schlae/plaid-bib-cpld/images/PlaidBibCPLD.jpg

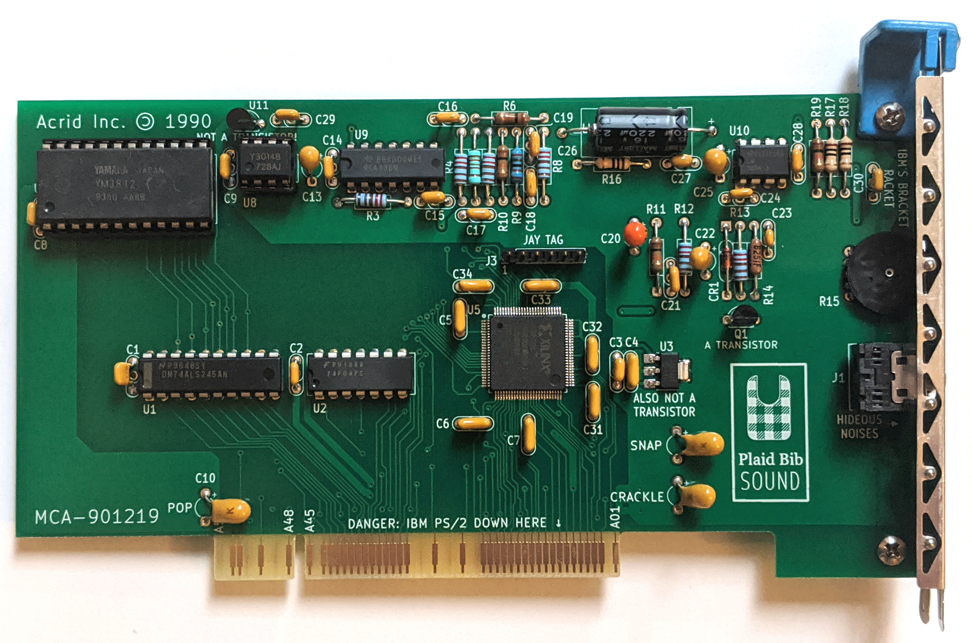
images/PlaidBibCPLD.jpg
