schlae/plaid-bib-cpld/PlaidBibCPLD.pdf

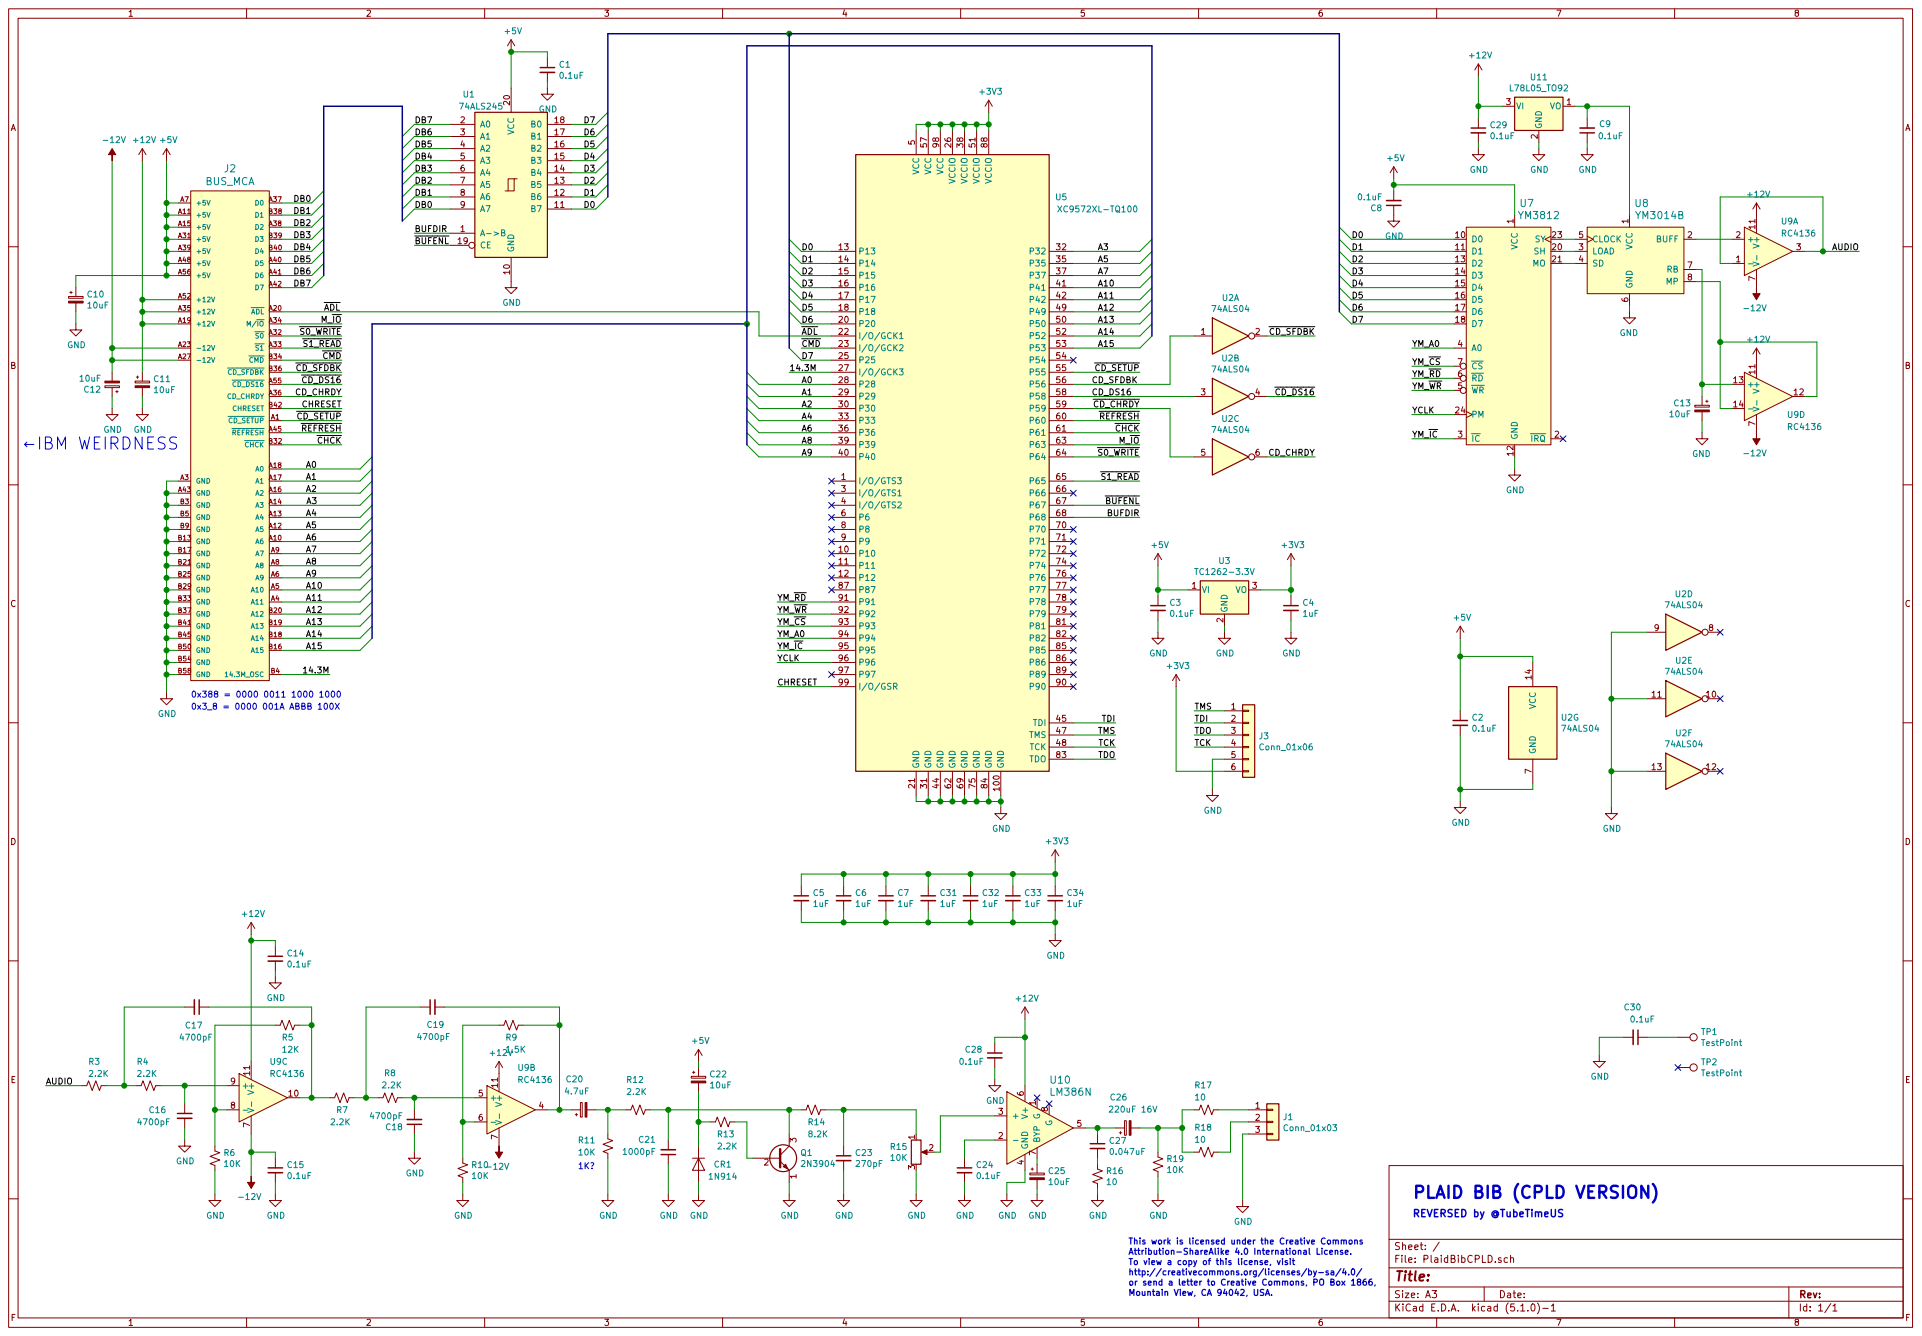
[picture p2: page 1]

+12V PLAID BIB (CPLD VERSION)
+5V GND

This work is licensed under the Creative Commons Attribution-ShareAlike 4.0 International License. To view a copy of this license, visit

http://creativecommons.org/licenses/by-sa/4.0/
or send a letter to Creative Commons, PO Box 1866,
Mountain View, CA 94042, USA.
