schlae/plaid-bib-cpld/PlaidBibCPLD.kicad_pcb

## KiCad design PlaidBibCPLD.kicad_pcb (2020-01-09)

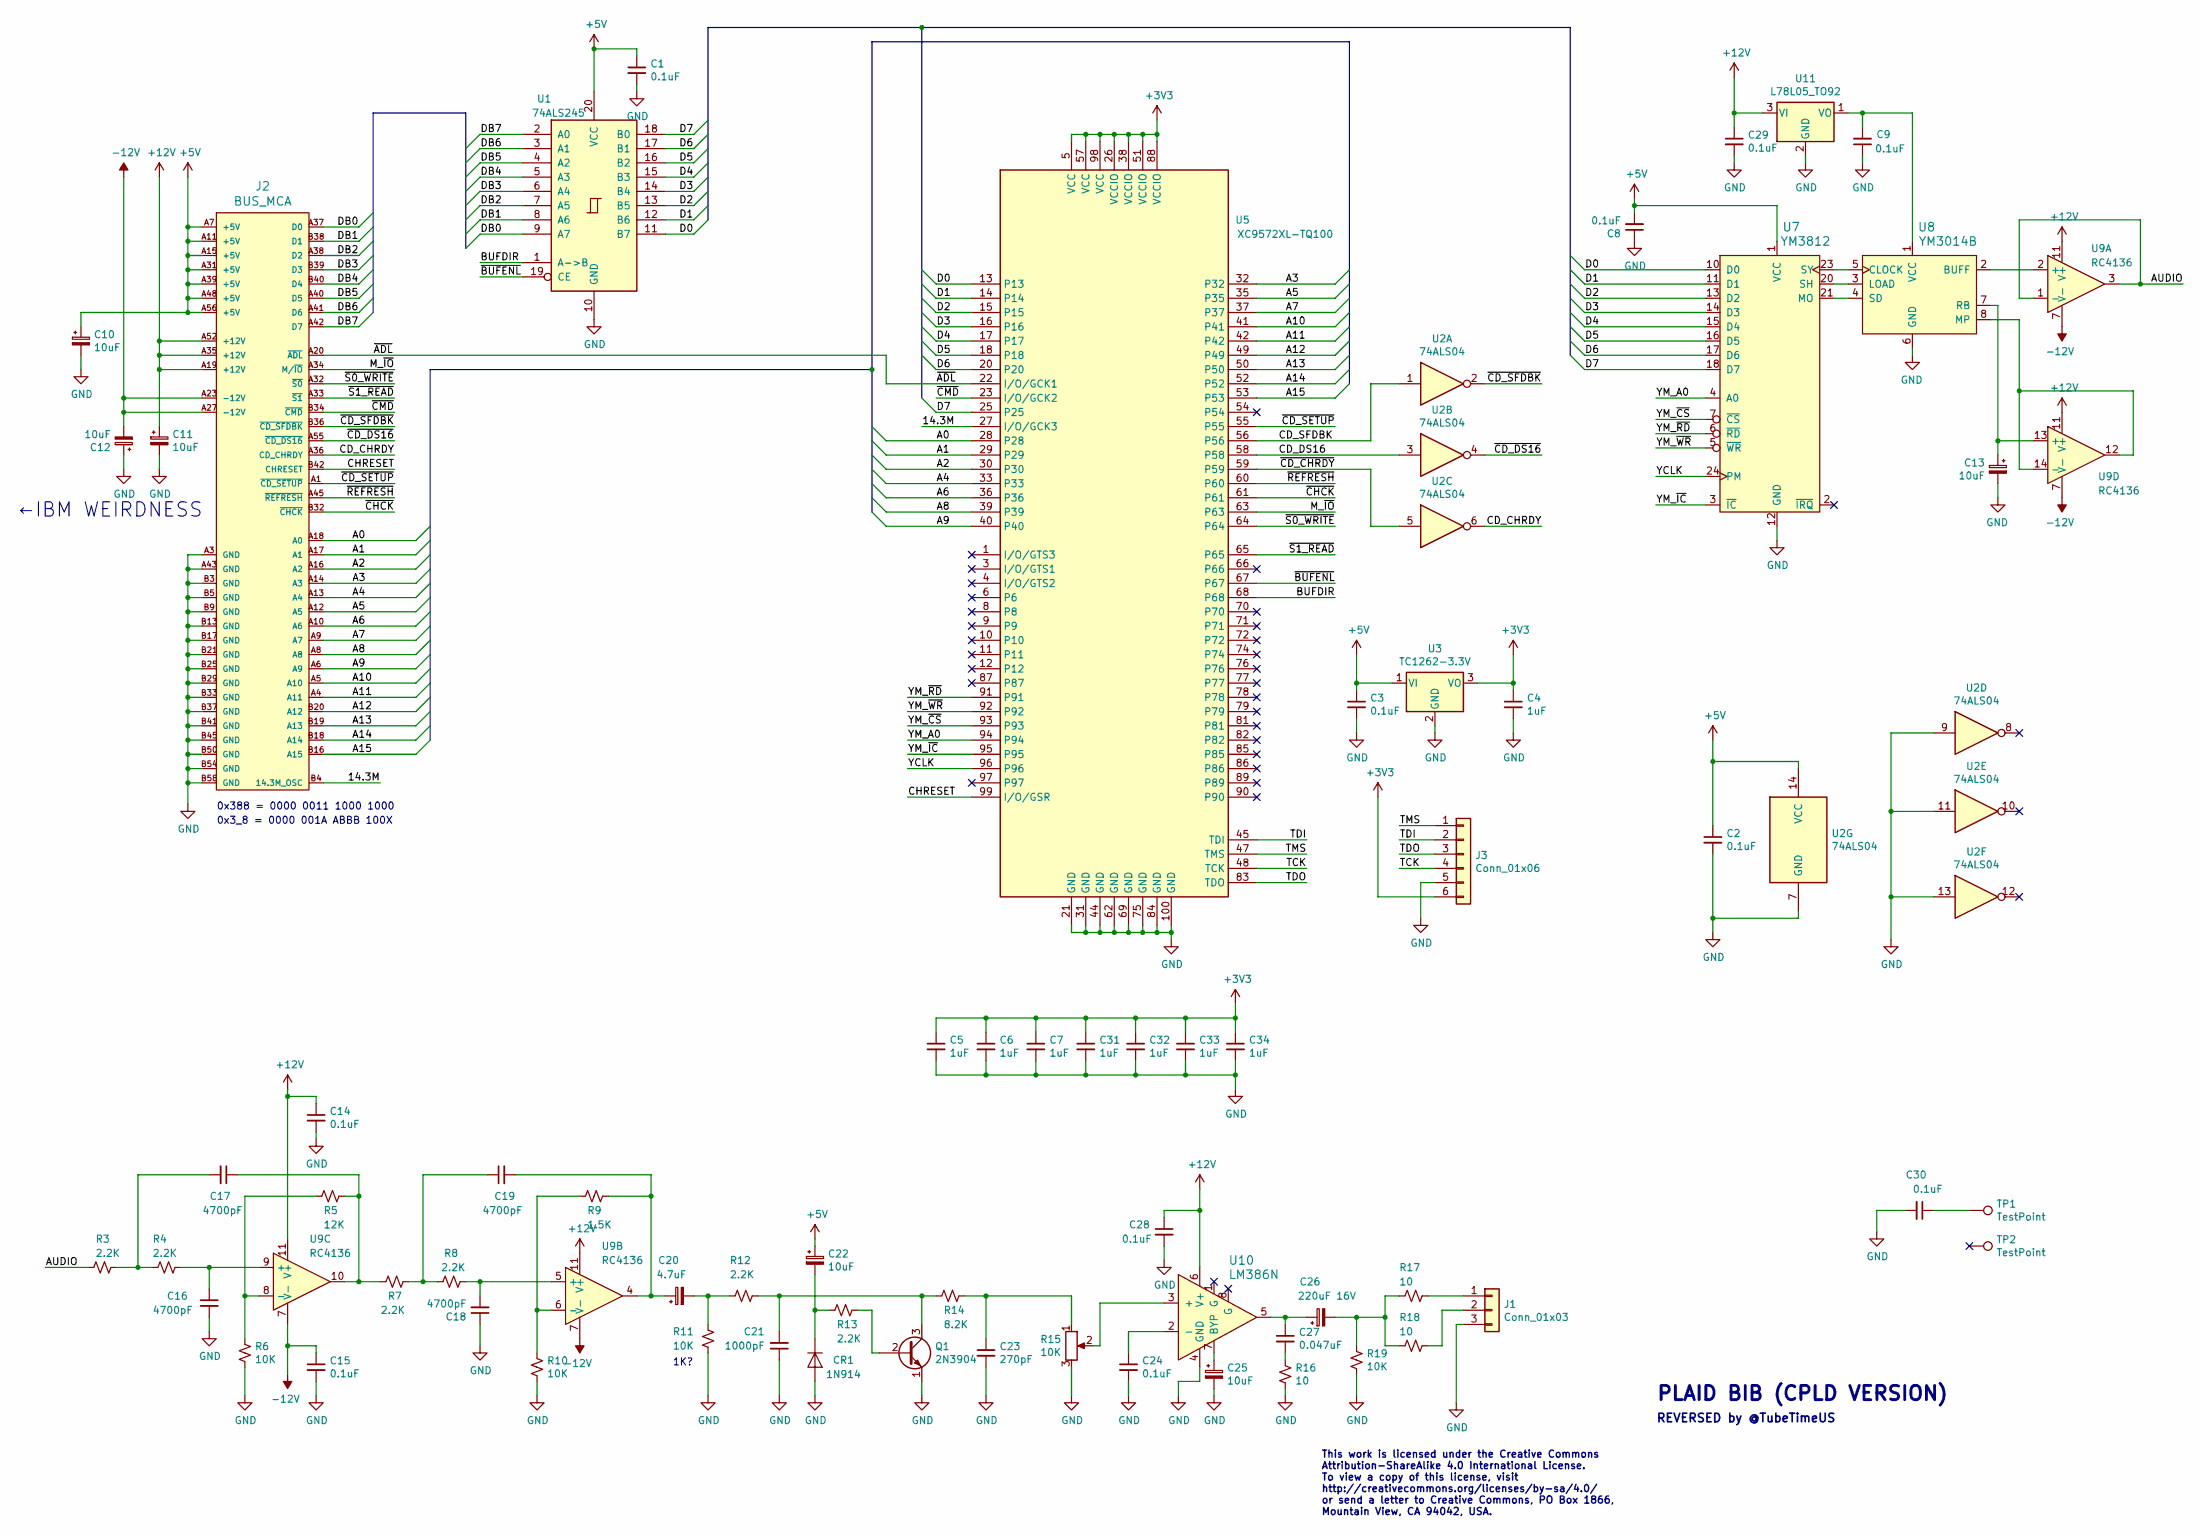
[picture p3: schematic PlaidBibCPLD.sch]

Parts:
C1, C2, C3, C8, C9, C14, C15, C24, C28, C29, C30: 0.1uF; CAP23; Mouser 581-AR215C104K4R
C4, C5, C6, C7, C31, C32, C33, C34: 1uF; CAP23; Mouser 581-AR215C104K4R
C10, C11, C12, C13, C22, C25: 10uF; CAPAP200; Mouser 581-TAP106M025CRW
C16, C17, C18, C19: 4700pF; CAP23; Mouser 581-AR211C472K4R
C20: 4.7uF; CAPAP200; Mouser 581-TAP475K016SCS
C21: 1000pF; CAP23; Mouser 581-AR211C102K4R
C23: 270pF; CAP23; Mouser 594-S271K43SL0N6TK5R
C26: 220uF 16V; CAPA1000; Mouser 647-TVX1C221MAD
C27: 0.047uF; CAP23; Mouser 581-AR215C473K4R
CR1: 1N914; DIOA500; Mouser 512-1N914
J1: Conn_01x03; SJ1-3553; Mouser 490-SJ1-3553NG
J2: BUS_MCA; BUS_MCA_ADLIB
J3: Conn_01x06; Pin_Header_Straight_1x06_Pitch2.54mm
Q1: 2N3904; TO92-IL; Mouser 512-2N3904BU
R3, R4, R7, R8, R12, R13: 2.2K; RESA500; Mouser 291-2.2K-RC
R5: 12K; RESA500; Mouser 291-12K-RC
R6, R10, R11, R19: 10K; RESA500; Mouser 291-10K-RC
R9: 1.5K; RESA500; Mouser 291-1.5K-RC
R14: 8.2K; RESA500; Mouser 291-8.2K-RC
R15: 10K; RK14J11A000G; Mouser 688-RK14J11A000G
R16, R17, R18: 10; RESA500; Mouser 291-10-RC
TP1, TP2: TestPoint; MH_125
U1: 74ALS245; DIP300_20N; Mouser 595-SN74ALS245AN
U2: 74ALS04; DIP254P762X635-14; Mouser 595-SN74ALS04BN
U3: TC1262-3.3V; SOT230P700X170-3; Mouser 579-TC1262-3.3VDB
U5: XC9572XL-TQ100; TQFP50P1600X1600X140-100; Mouser 217-9572XL-10TQG100C
U7: YM3812; DIP600_24N
U8: YM3014B; DIP300_8N
U9: RC4136; DIP300_14N; Mouser 595-RC4136N
U10: LM386N; DIP300_8N; Mouser 926-LM386N-4/NOPB
U11: L78L05_TO92; TO92-IL; Mouser 511-L78L05ACZ

Connections:
+3V3: C4.1, C5.1, C6.1, C7.1, C31.1, C32.1, C33.1, C34.1, J3.6, U3.3 (VO), U5.5 (VCC), U5.26 (VCCIO), U5.38 (VCCIO), U5.51 (VCCIO), U5.57 (VCC), U5.88 (VCCIO), U5.98 (VCC)
+5V: C1.1, C2.1, C3.1, C8.2, C10.1, C22.1, J2.A7 (+5V), J2.A11 (+5V), J2.A15 (+5V), J2.A31 (+5V), J2.A39 (+5V), J2.A48 (+5V), J2.A56 (+5V), U1.20 (VCC), U2.14 (VCC), U3.1 (VI), U7.1 (VCC)
+12V: C11.1, C14.1, C28.1, C29.1, J2.A19 (+12V), J2.A35 (+12V), J2.A52 (+12V), U9.11 (V+), U10.6 (V+), U11.3 (VI)
-12V: C12.2, C15.1, J2.A23 (-12V), J2.A27 (-12V), U9.7 (V-)
/14.3M: J2.B4 (14.3M_OSC), U5.27 (I/O/GCK3)
/A0: J2.A18 (A0), U5.28
/A1: J2.A17 (A1), U5.29
/A2: J2.A16 (A2), U5.30
/A3: J2.A14 (A3), U5.32
/A4: J2.A13 (A4), U5.33
/A5: J2.A12 (A5), U5.35
/A6: J2.A10 (A6), U5.36
/A7: J2.A9 (A7), U5.37
/A8: J2.A8, U5.39
/A9: J2.A6 (A9), U5.40
/A10: J2.A5 (A10), U5.41
/A11: J2.A4 (A11), U5.42
/A12: J2.B20 (A12), U5.49
/A13: J2.B19 (A13), U5.50
/A14: J2.B18 (A14), U5.52
/A15: J2.B16 (A15), U5.53
/AUDIO: R3.2, U9.1 (-), U9.3
/BUFDIR: U1.1 (A->B), U5.68
/CD_CHRDY: J2.A36 (CD_CHRDY), U2.6
/CD_DS16: U2.3, U5.58
/CD_SFDBK: U2.1, U5.56
/CHRESET: J2.B42 (CHRESET), U5.99 (I/O/GSR)
/D0: U1.11 (B7), U5.13, U7.10 (D0)
/D1: U1.12 (B6), U5.14, U7.11 (D1)
/D2: U1.13 (B5), U5.15, U7.13 (D2)
/D3: U1.14 (B4), U5.16, U7.14 (D3)
/D4: U1.15 (B3), U5.17, U7.15 (D4)
/D5: U1.16 (B2), U5.18, U7.16 (D5)
/D6: U1.17 (B1), U5.20, U7.17 (D6)
/D7: U1.18 (B0), U5.25, U7.18 (D7)
/DB0: J2.A37 (D0), U1.9 (A7)
/DB1: J2.B38 (D1), U1.8 (A6)
/DB2: J2.A38 (D2), U1.7 (A5)
/DB3: J2.B39 (D3), U1.6 (A4)
/DB4: J2.B40 (D4), U1.5 (A3)
/DB5: J2.A40 (D5), U1.4 (A2)
/DB6: J2.A41 (D6), U1.3 (A1)
/DB7: J2.A42 (D7), U1.2 (A0)
/M_~IO: J2.A34 (M/~IO), U5.63
/TCK: J3.4, U5.48 (TCK)
/TDI: J3.2, U5.45 (TDI)
/TDO: J3.3, U5.83 (TDO)
/TMS: J3.1, U5.47 (TMS)
/YCLK: U5.96, U7.24 (PM)
/YM_A0: U5.94, U7.4 (A0)
/YM_~CS: U5.93, U7.7 (~CS)
/YM_~IC: U5.95, U7.3 (~IC)
/YM_~RD: U5.91, U7.6 (~RD)
/YM_~WR: U5.92, U7.5 (~WR)
/~ADL: J2.A20 (~ADL), U5.22 (I/O/GCK1)
/~BUFENL: U1.19 (CE), U5.67
/~CD_CHRDY: U2.5, U5.59
/~CD_DS16: J2.A55 (~CD_DS16), U2.4
/~CD_SETUP: J2.A1 (~CD_SETUP), U5.55
/~CD_SFDBK: J2.B36 (~CD_SFDBK), U2.2
/~CHCK: J2.B32 (~CHCK), U5.61
/~CMD: J2.B34 (~CMD), U5.23 (I/O/GCK2)
/~REFRESH: J2.A45 (~REFRESH), U5.60
/~S0_WRITE: J2.A32 (~S0), U5.64
/~S1_READ: J2.A33 (~S1), U5.65
GND: C1.2, C2.2, C3.2, C4.2, C5.2, C6.2, C7.2, C8.1, C9.1, C10.2, C11.2, C12.1, C13.2, C14.2, C15.2, C16.2, C18.1, C21.1, C23.2, C24.2, C25.2, C28.2, C29.2, C30.2, C31.2, C32.2, C33.2, C34.2, CR1.2 (A), J1.3, J2.A3 (GND), J2.A43 (GND), J2.B3 (GND), J2.B5 (GND), J2.B9 (GND), J2.B13 (GND), J2.B17 (GND), J2.B21 (GND), J2.B25 (GND), J2.B29 (GND), J2.B33 (GND), J2.B37 (GND), J2.B41 (GND), J2.B45 (GND), J2.B50 (GND), J2.B54 (GND), J2.B58 (GND), J3.5, Q1.1 (E), R6.2, R10.2, R11.2, R15.3, R16.2, R19.2, U1.10 (GND), U2.7 (GND), U2.9, U2.11, U2.13, U3.2 (GND), U5.21 (GND), U5.31 (GND), U5.44 (GND), U5.62 (GND), U5.69 (GND), U5.75 (GND), U5.84 (GND), U5.100 (GND), U7.12 (GND), U8.6 (GND), U10.4 (GND), U11.2 (GND)
unnamed: C9.2, U8.1 (VCC), U11.1 (VO)
unnamed: C13.1, U8.7 (RB), U9.13 (+)
unnamed: C16.1, R4.1, U9.9 (+)
unnamed: C17.1, R5.1, R7.2, U9.10
unnamed: C17.2, R3.1, R4.2
unnamed: C18.2, R8.2, U9.5 (+)
unnamed: C19.1, R7.1, R8.1
unnamed: C19.2, C20.1, R9.1, U9.4
unnamed: C20.2, R11.1, R12.2
unnamed: C21.2, Q1.3 (C), R12.1, R14.2
unnamed: C22.2, CR1.1 (K), R13.2
unnamed: C23.1, R14.1, R15.1
unnamed: C24.1, U10.2 (-)
unnamed: C25.1, U10.7 (BYP)
unnamed: C26.1, C27.1, U10.5
unnamed: C26.2, R17.1, R18.1, R19.1
unnamed: C27.2, R16.1
unnamed: C30.1, TP1.1
unnamed: J1.1, R17.2
unnamed: J1.2, R18.2
unnamed: Q1.2 (B), R13.1
unnamed: R5.2, R6.1, U9.8 (-)
unnamed: R9.2, R10.1, U9.6 (-)
unnamed: R15.2, U10.3 (+)
unnamed: U7.20 (SH), U8.3 (LOAD)
unnamed: U7.21 (MO), U8.4 (SD)
unnamed: U7.23 (SY), U8.5 (CLOCK)
unnamed: U8.2 (BUFF), U9.2 (+)
unnamed: U8.8 (MP), U9.12, U9.14 (-)

Notes on the sheet:
0x388 = 0000 0011 1000 1000
1K?
←IBM WEIRDNESS
0x3_8 = 0000 001A ABBB 100X
PLAID BIB (CPLD VERSION)
REVERSED by @TubeTimeUS
This work is licensed under the Creative Commons Attribution-ShareAlike 4.0 International License. To view a copy of this license, visit http://creativecommons.org/licenses/by-sa/4.0/ or send a letter to Creative Commons, PO Box 1866, Mountain View, CA 94042, USA.

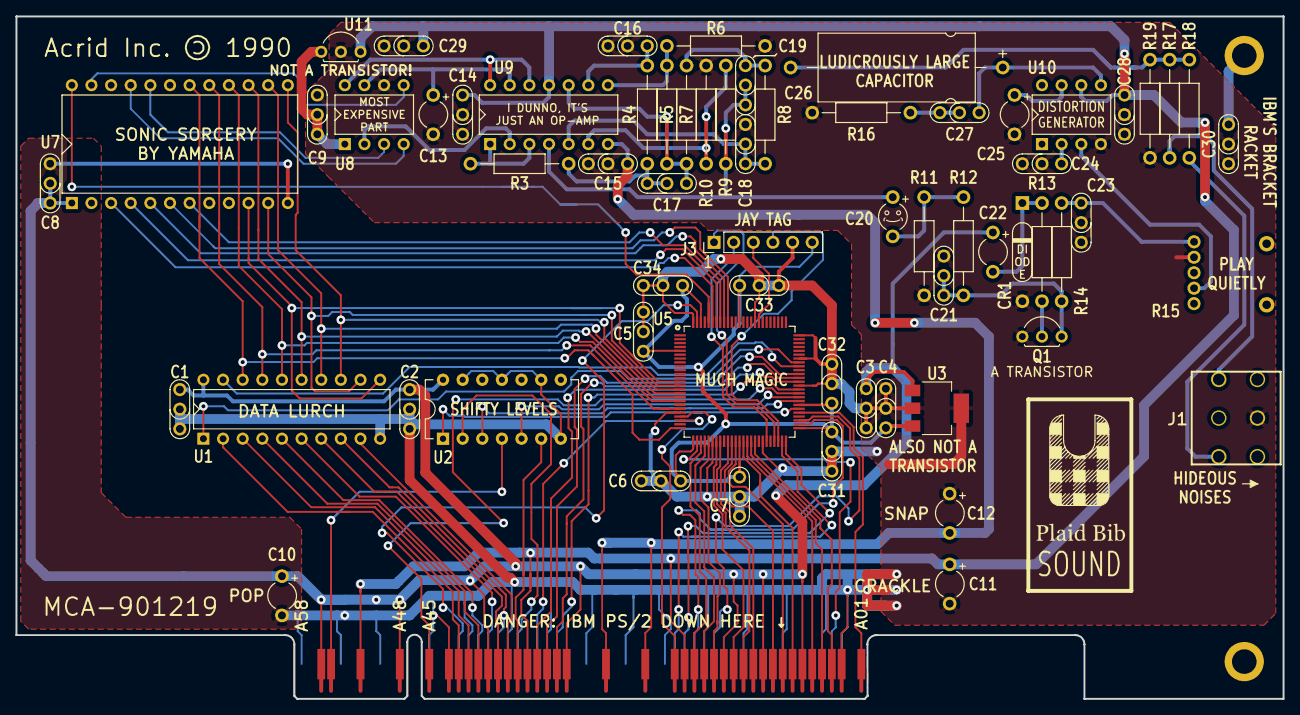
[picture p4: board PlaidBibCPLD.kicad_pcb from above]

Board: 2 copper layers, 163.9 x 88.3 mm, 67 parts (0 on the bottom side), 95 nets.
